Sunshine-Scooters/control-code/Wiring Diagram.pdf

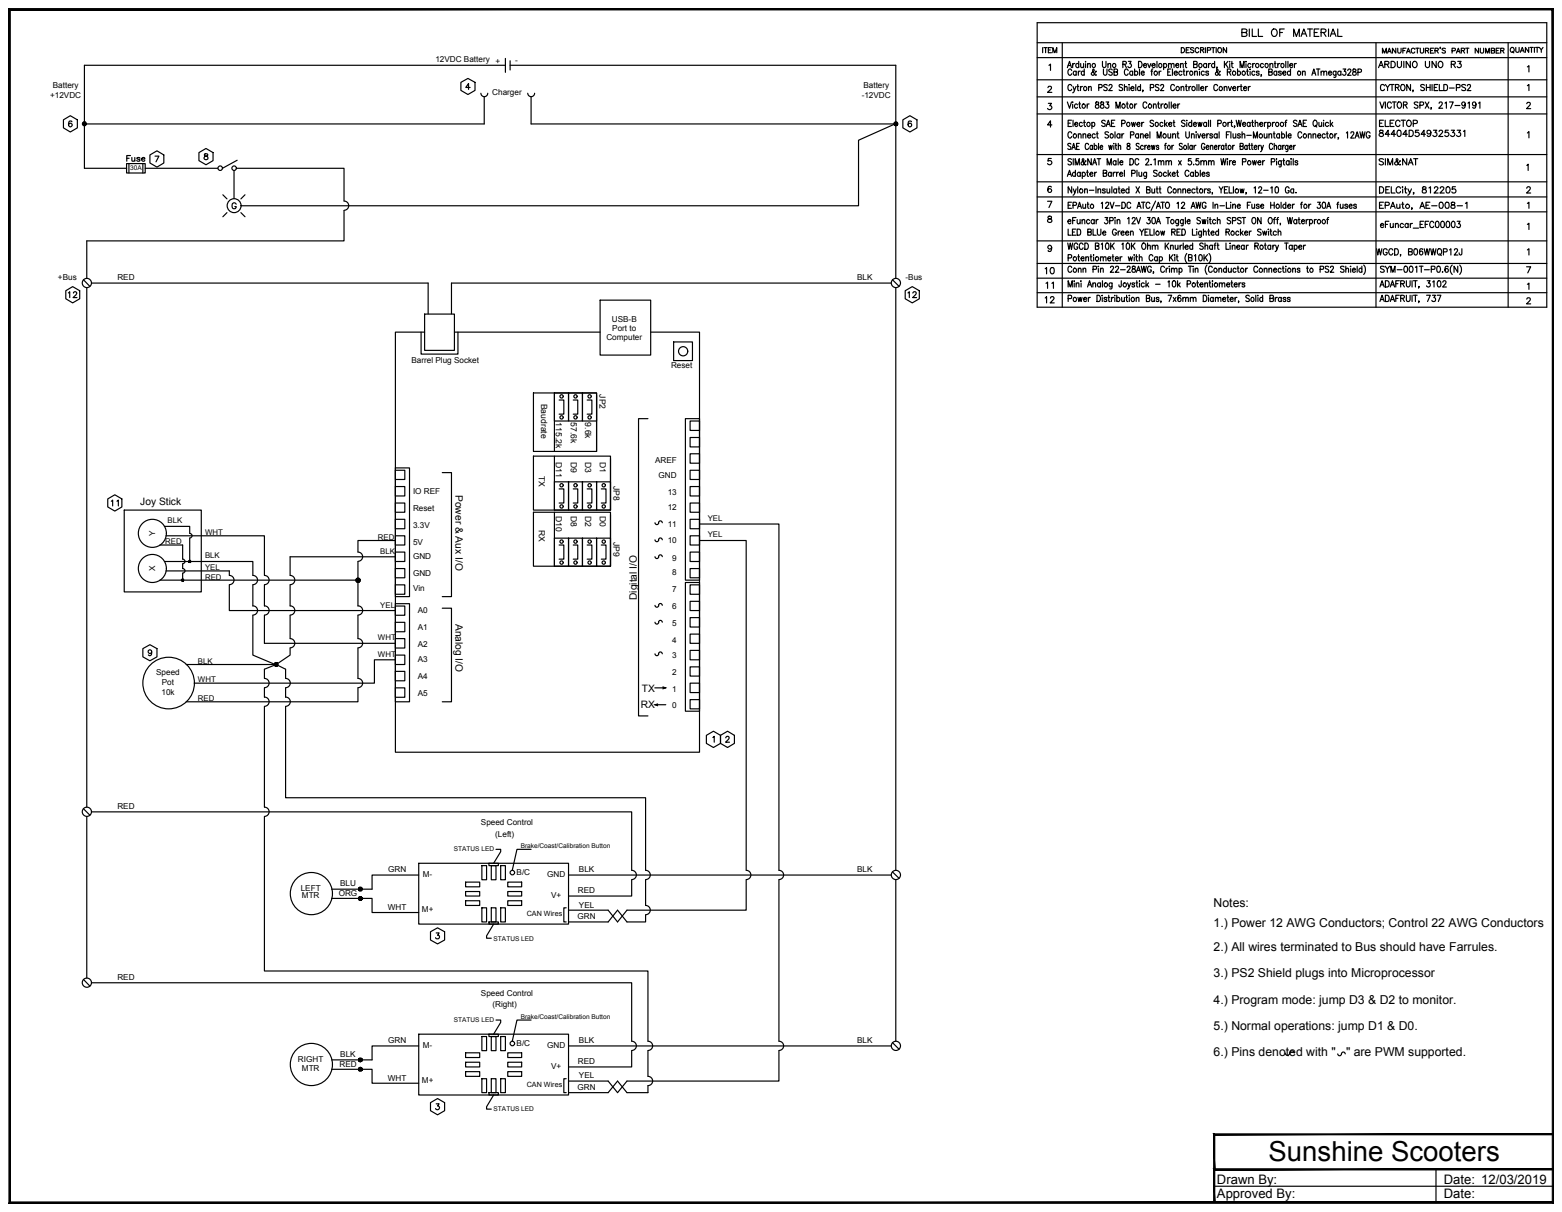
[picture p1: page 1]

Brake/Coast/Calibration Button STATUS LED

Notes:
1.) Power 12 AWG Conductors; Control 22 AWG Conductors

2.) All wires terminated to Bus should have Farrules.

3.) PS2 Shield plugs into Microprocessor

4.) Program mode: jump D3 & D2 to monitor.

6.) Pins denoted with " " are PWM supported.
